KINGFIOX/minirv/(commit log)

2024-07-11 删掉了一些冗余的
2024-07-11 格式化代码配置
2024-07-11 移动位置, 结构
2024-07-11 添加 NPC
2024-07-11 注释掉编译错误
2024-07-11 改了ALU结构
2024-07-11 添加了一些指令
2024-07-11 alu 变为纯粹的计算了
2024-07-11 明确 alu 与 bru 的职责
2024-07-11 明确 npc 职责
2024-07-11 编译生成的
2024-07-11 :tada: SEXTU 好耶
2024-07-12 移位运算
2024-07-12 符号拓展 u
2024-07-12 拓展 u 包括: 零拓展 + 符号拓展
2024-07-12 csr u, 内置有 csr_regfile
2024-07-12 添加注释
2024-07-12 :art: 结构
2024-07-12 :art: 封装了一下 Mem
2024-07-12 :tada: 访存单元
2024-07-12 添加访存相关的参数 但是有待商榷
2024-07-12 符号拓展还是不能有 zext
2024-07-12 独立的 zextu
2024-07-12 zero禁止写入
2024-07-12 规范符号
2024-07-12 规范端口
2024-07-12 todo 为了支持 ecall 和 mret, CSRU 需要做什么
2024-07-12 :tada: 解码
2024-07-12 添加不访问 MemU
2024-07-12 添常数, 注释
2024-07-12 添加控制信号
2024-07-14 rename: 控制单元
2024-07-14 新增 PC
2024-07-14 有符号运算, 虽然好像没啥区别
2024-07-14 尝试连接模块
2024-07-14 csr 发现这个有点麻烦, 可能是我想的麻烦了, 学校给的其实挺简单的
2024-07-14 生成的sv代码
2024-07-14 测试一下 bitpat
2024-07-14 想要搞一个日志系统
2024-07-14 添加一些辅助工具
2024-07-14 WIP: CSR 参考 NutShell
2024-07-14 改进 control unit 参考 罗老
2024-07-14 SEXTU 可能不一定存在
2024-07-14 去掉 u, 单词拼写不对
2024-07-14 添加blackbox -> ip 核
2024-07-14 分时复用数码管
2024-07-14 隐式参数
2024-07-15 地址交叉的DRAM
2024-07-15 数码管, 写注释
2024-07-15 数码管, 注释
2024-07-15 :art: 优化结构
2024-07-15 trait Consts, 但是好像没啥用
2024-07-15 取指令阶段
2024-07-15 copy of 萝老
2024-07-15 单例, 用于时钟降低频率
2024-07-15 两个合并了
2024-07-15 IF 其实是一个大号的 PC, 并非一个 IF
2024-07-15 移动一下位置
2024-07-15 debug 线, 用于与verilator交互
2024-07-15 向上取整
2024-07-15 总线设备
2024-07-15 :art: 参数化
2024-07-16 :art: 线束打包
2024-07-16 MemU 写文档, 约束
2024-07-16 去掉 private, 发现搞错了
2024-07-16 store指令
2024-07-16 load 指令
2024-07-16 :bug: 还好看了一下 .sv, 忘记给 rd_i 赋值了
2024-07-16 I-type 指令
2024-07-16 _v 表示 value, _i 表示 index
2024-07-16 实现 branch 指令
2024-07-16 auipc, lui, jalr, jal, branch 指令实现
2024-07-16 :tada: CPUCore 现在可以编译出来了
2024-07-16 :bug: 差点死循环了
2024-07-16 看看原理是啥
2024-07-16 啥也没干
2024-07-16 符合trace要求
2024-07-16 添加可配置选项
2024-07-16 移动文件, 需要用到ip核的, 就放到vivado中
2024-07-16 移动文件
2024-07-16 重新放回去, 发现好像没啥
2024-07-16 trace 的 Mem
2024-07-16 文件移动
2024-07-16 添加 IROM
2024-07-16 :tada: 耶, generate .sv
2024-07-17 将 IF_ID_Bundle 放到了 IF.scala 中
2024-07-17 添加调试日志
2024-07-17 这两个多余了, 不需要了
2024-07-17 :bug: 立即数忘记符号拓展了
2024-07-17 :bug: branch 指令
2024-07-17 因为的时序与golden model正好是差了一个周期, 因为我直接来一个 RegNext 延迟一个周期, 有种土鳖中的战斗鳖的感觉
2024-07-17 :bug: 修复 sb/sh 的问题
2024-07-17 :art: 重构代码
2024-07-23 :art: 改善代码结构
2024-07-24 :art: 重命名, 总线桥结构
2024-07-25 把 regfile 封装成一个模块
2024-07-25 pipeline, 很神奇的东西
2024-07-26 :art: 优化 regfile
2024-07-26 :art: 改善了代码结构
2024-07-26 wb_wen信号
2024-07-26 :art: 模块化 EXE
2024-07-26 :art: 打包
2024-07-26 :art: 把线都绑好了, 就是有点乱, 看不清了已经
2024-07-26 pipeline 直接来吧
2024-07-27 :beers: branch 和 jmp 处理
2024-07-27 现在使用停顿
2024-07-27 :art: 输出, 对接 trace
2024-07-27 转发write
2024-07-27 :art: 结构调整
2024-07-27 :art: 数据冒险
2024-07-27 :bug: 修复 jalr 的 bug
2024-07-27 :tada: debug 完毕, 爽
2024-07-27 删掉一个 lb 日志
2024-07-30 :bug: 修复一个问题
2024-07-31 :wrench: 子项目
2024-08-26 优化了一下结构
2024-08-26 :art: 实现vivado
2024-08-28 写random
2024-08-29 测试程序
2024-08-29 :bug: 修复了一个问题
2024-08-29 :bug: 往回流的数据使用_l流水段, 修复ld_hazard的错误检测
2024-08-29 :teda: 完善实验的asm, 但是外设有点小问题(
2024-08-29 :teda: 重新引入学校的差分测试
2024-08-29 更改submodule的路径
2024-08-29 更新random程序
2024-08-29 优化branch的视线
2024-08-29 :docs: 写实验报告
2024-08-29 :docs: 写报告
2024-08-30 波形分析
2024-08-30 写实验报告
